TommyGymer/TVC-system/sketch_3D_interface/README.md

# Sketch 3D Interface

This is a short serial program written in Processing (a Java based rendering platform)
It takes the serial data from the Arduino and outputs a cube with the measured rotations applied
This allowed easier debugging of the Arduino code as it visuallises the measured and calculated movement

# Videos

Raw demo videos are the videos I took to demo the functinallity of the prototype I had managed at that point
The edited videos shows slighlt cut down versions which have been uploaded to a YouTube channel for ease of viewing

- [First demo](https://youtu.be/H80VO9Qbj1g)
- [Euler angle demo](https://youtu.be/j1J1uJ9cu_Y)
- [Final demo](https://youtu.be/IOriJy_zD2g)
