TommyGymer/TVC-system/servos/README.md

# Servo control

This is a library written to allow the control of a specific servo I happened to have on hand.
The library takes a range of movement in radians at initialisation and can then be given angles to move to.
