TommyGymer/TVC-system/servos/servo_test/README.md

# Servo testing

This sketch contains the code I used to find the range of the servo I was using to input into the library.
