TommyGymer/TVC-system/(threads)

Thread 4 (2021-06-07):

Tilt correction not working - #1

TommyGymer, 2021-06-07:
Tilt correction should be applied outside the main angular velocity loop

TommyGymer, 2021-06-07:
Tilt correction term moved outside the angular velocity loop

Closed 2021-06-07.
