TommyGymer/TVC-system/(commit log)

2021-05-27 Added posts
    Added a post to the journal about GitHub and my usage of it.
    Added a post about the progress with the artefact.
    Added the correct Arduino code.
    [icm20948_unifiedsensors.ino]
2021-06-03 Corrected data from Arduino
    Unit is rad/s.
    Was using velocity * time * time as displacement.
    Corrected to velocity * time.
    [icm20948_unifiedsensors.ino, sketch_3D_interface.pde]
2021-06-03 Connected real and cube
    The cube now matches real movements with a small amount of drift.
    Removed unused libraries and irrelevant comments.
    [icm20948_unifiedsensors.ino, sketch_3D_interface.pde]
2021-06-04 Debugging the offset calculation
    Offsets were always zero
    Printing out all the data to find the issue
    [icm20948_unifiedsensors.ino]
2021-06-04 Fixed the offset calculation
    Offset calculation fixed
    Changed data type from long to float as the values were no longer integers as they used to be
    [icm20948_unifiedsensors.ino]
2021-06-04 Quaternions implemented
    Quaternions implemented and tested
    Works every pi radians in the z-axis
    Experiences gimble-lock of some description at pi / 2 offsets around the z-axis
2021-06-05 Accelerometer tilt correction
    Using the accelerometer to calculate and apply a tilt correction based on the direction of gravity
    Written a new library to define quaternions
    Need to weight the returned values by the tilt correction
    [Quat.cpp, Quat.h, icm20948_unifiedsensors.ino]
2021-06-06 More tilt correction
    Added conjugate and inverse to the quaternion lib
    Added a first version of the tilt correction
    Not working correctly yet; it appears to be too sensitive, not sure on the reason yet
    [Quat.cpp, Quat.h, icm20948_unifiedsensors.ino]
2021-06-06 Corrections to quaternion logic
    Corrected some bugs in both code and logic
    The tilt correction is still incorrect, though seems to assist in return to neutral position
    [Quat.cpp, Quat.h, icm20948_unifiedsensors.ino, sketch_3D_interface.pde]
2021-06-07 Tilt correction outside loop
    Moved the tilt correction outside the loop to not include it in the angular velocity tracking
    [icm20948_unifiedsensors.ino]
2021-06-07 Tilt correction solved
    Tilt correction is now functioning correctly
    Extra division of gyro data caused this issue and was also the cause of a disparity between the "radians" on the Arduino and the radians on the Processing sketch
    [icm20948_unifiedsensors.ino, sketch_3D_interface.pde]
2021-06-07 Created servo_test.ino
    Servo testing:
    Servo can be swept through different values
    Servo can be powered by the Arduino
2021-06-07 Servo limit testing
    Testing the limits of the servo to find the minimum and maximum value that can be input into the Arduino servo library without straining the servo
    Also finding the relation between the values given to the servo and the physical angle turned by the servo
2021-06-07 Interpolation function
    Creating a function to interpolate between an angle in radians and the value required by the servo
2021-06-07 Servo library complete
    Servo library allows creation of custom servo objects which use the standard Arduino servo library to communicate with the servo
    Functionality to map angles between a min and max given the range of angles had been added
2021-06-10 Testing rotation methods
    Testing the use of a 4x4 matrix to rotate the cube rather then the Euler angles
    Tested using ZXY order of rotation rather than XYZ to try solve the gimble lock issues
    [sketch_3D_interface.pde]
2021-06-10 Settling on ZXY
    Settling on the ZXY rotation order solution to the gimbal lock issue
    This should reduce the chances of reaching a state of gimbal lock, though it is not a full solution
    [sketch_3D_interface.pde]
2021-06-11 Refining tilt correction
    Refining the use of the tilt correction from the accelerometer to improve the rotation estimate
    Including a correction term from the tilt correction in the full estimation loop
    [icm20948_unifiedsensors.ino]
2021-06-14 Axis angle with servo
    Axis angle implementation implemented using "rotate()"
    Tested and confirmed functionality in all three axis with no gimbal lock
    Used the PServo library developed on the servo branch to connect estimated rotation to the servo
    [accelerometer analysis.xlsx]
2021-07-06 Updating record of development
    Adding changes to the record of developement:
    - Added images to some of the entries
    - Updated record to current point in time
2021-07-06 Updated final entry
    Added comment about the servo to the record of development
2021-07-23 Added evaluation
    Added evaluation to the record of development at many of the important stages.
